cosmic-pi-deprecated/ANALOGUE-hardware/AnalogueProductionBOM.xlsx

Qty | Value | Parts | Package | Tolerance | Wattage | Voltage Rating, Type | Manufacturer | MPN | Description | Device | Side | Mounting
1 | 0 ohm | R9 | R1206 |  | 1/4W |  |  |  | RESISTOR, European symbol | R-EU_R1206 | Top | SMD
1 | 1 uH CM choke | L1 | WE-CNSW_1812 |  |  |  | Wurth | 744235601 | WE-CNSW SMD Common Mode Line Filter | WE-CNSW_1812_744235601 | Top | SMD
6 | 100n | C14, C15, C19, C20, C24, C25 | C0603 | 10% |  | 50V, X7R |  |  | CAPACITOR, European symbol | C-EUC0603 | Top | SMD
2 | 100n ECPU | C1, C16 | C0805 | 20% |  | 16V |  |  | CAPACITOR, European symbol | C-EUC0805 | Top | SMD
1 | 100u | C6 | C/6032-28R | 10% |  | 10V, Tantalum |  |  | POLARIZED CAPACITOR, European symbol | CPOL-EUC/6032-28R | Top | SMD
3 | 10K | R25, R32, R33 | R0805 | 0.1% | 125mW |  |  |  | RESISTOR, European symbol | R-EU_R0805 | Top | SMD
1 | 10n | C8 | C0603 | 10% |  | 50V, X7R |  |  | CAPACITOR, European symbol | C-EUC0603 | Top | SMD
2 | 1K | R17, R26 | R0603 | 1% | 1/10W |  |  |  | RESISTOR, European symbol | R-EU_R0603 | Top | SMD
4 | 1k | R1, R2, R15, R16 | R1206 | 1% | 1/4W |  |  |  | RESISTOR, European symbol | R-EU_R1206 | Top | SMD
1 | 1u | C7 | C0603 | 10% |  | 25V, X7R |  |  | CAPACITOR, European symbol | C-EUC0603 | Top | SMD
4 | 1u | C2, C3, C21, C22 | C1206 | 10% |  | 100V, X7R |  |  | CAPACITOR, European symbol | C-EUC1206 | Top | SMD
1 | 2.2u | C11 | C0603 | 10% |  | 10V, X7R |  |  | CAPACITOR, European symbol | C-EUC0603 | Top | SMD
2 | 20 | R7, R8 | R0603 | 1% | 1/10W |  |  |  | RESISTOR, European symbol | R-EU_R0603 | Top | SMD
1 | 22-23-2021 | X3 | 22-23-2021 |  |  |  | MOLEX | 22-23-2021 | .100 (2.54mm) Center Header - 2 Pin" | 22-23-2021 | Top | TH
2 | 22-23-2041 | X1, X2 | 22-23-2041 |  |  |  | MOLEX | 22-23-2041 | .100 (2.54mm) Center Header - 4 Pin" | 22-23-2041 | Top | TH
2 | 30K | R18, R27 | R0603 | 1% | 1/10W |  |  |  | RESISTOR, European symbol | R-EU_R0603 | Top | SMD
2 | 30p NP0 | C4, C17 | C0603 | 5% |  | 50V, NPO |  |  | CAPACITOR, European symbol | C-EUC0603 | Top | SMD
1 | 330 | R22 | R0603 | 1% | 1/10W |  |  |  | RESISTOR, European symbol | R-EU_R0603 | Top | SMD
2 | 5100 | R24, R28 | R0603 | 1% | 1/8W |  |  |  | RESISTOR, European symbol | R-EU_R0603 | Top | SMD
2 | AD8039 | IC1, IC2 | SO8 |  |  |  | Analogue Devices | AD8039ARZ | Low Power, 350 MHz Voltage Feedback Amplifiers, 3V | AD8039R | Top | SMD
2 | BAS70-04 | D3, D4 | SOT23 |  |  |  | Vishay | BAS70-04-E3-08 | Silicon Schottky Diodes | BAS70-04 | Top | SMD
1 | LP2985IM5-3.1 | IC3 | SOT95P284X120-5N |  |  |  | Texas Instruments | LP2985IM5-3.3/NOPB | Low-Dropout Regulator | LP2985IM5-3.1 | Top | SMD
2 | U.FL-R-SMT-1(10) | J1, J2 | HRS_U.FL-R-SMT-1(10) |  |  |  | Hirose | U.FL-R-SMT-1(10) | U.FL, Ultra Miniature Coaxial Connector Receptacle, Male Pin 50 Ohm Surface Mount Solder | U.FL-R-SMT-1(10) | Top | SMD
1 | top-mounted | LED1 | LED_SML0603 |  |  |  | LTST-S270TBKT-5A |  | 0603 Blue LED | LED_ESML0603 | Top | SMD
