cosmic-pi-deprecated/ANALOGUE-hardware/Cosmic Pi Analogue V2.5 OHL.pdf

# Signal

# +4V Regulated Power Supply

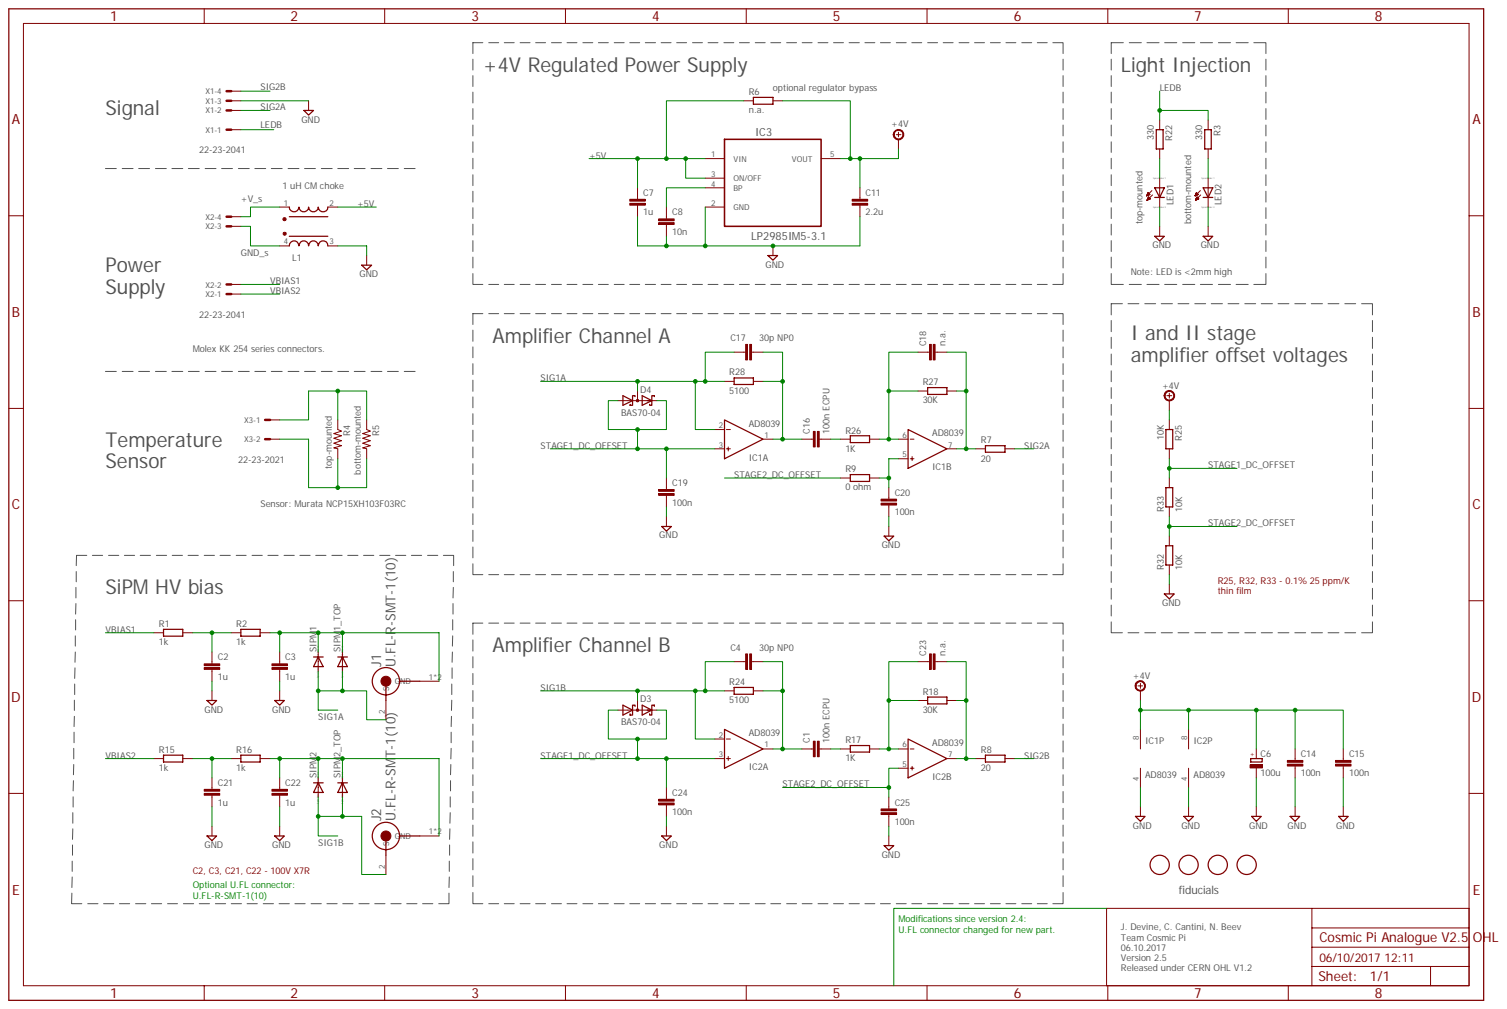
[picture p1: page 1]

Note: LED is <2mm high

Molex KK 254 series connectors.

SpiceOrder 1 SpiceOrder 2

Modifications since version 2.4:
U.FL connector changed for new part.

J. Devine, C. Cantini, N. Beev
Team Cosmic Pi
Version 2.5
Released under CERN OHL V1.2
