cosmic-pi-deprecated/ANALOGUE-hardware/Cosmic Pi Analogue V2.5 OHL no logo.brd

## EAGLE design Cosmic Pi Analogue V2.5 OHL no logo.brd (2017-10-26)

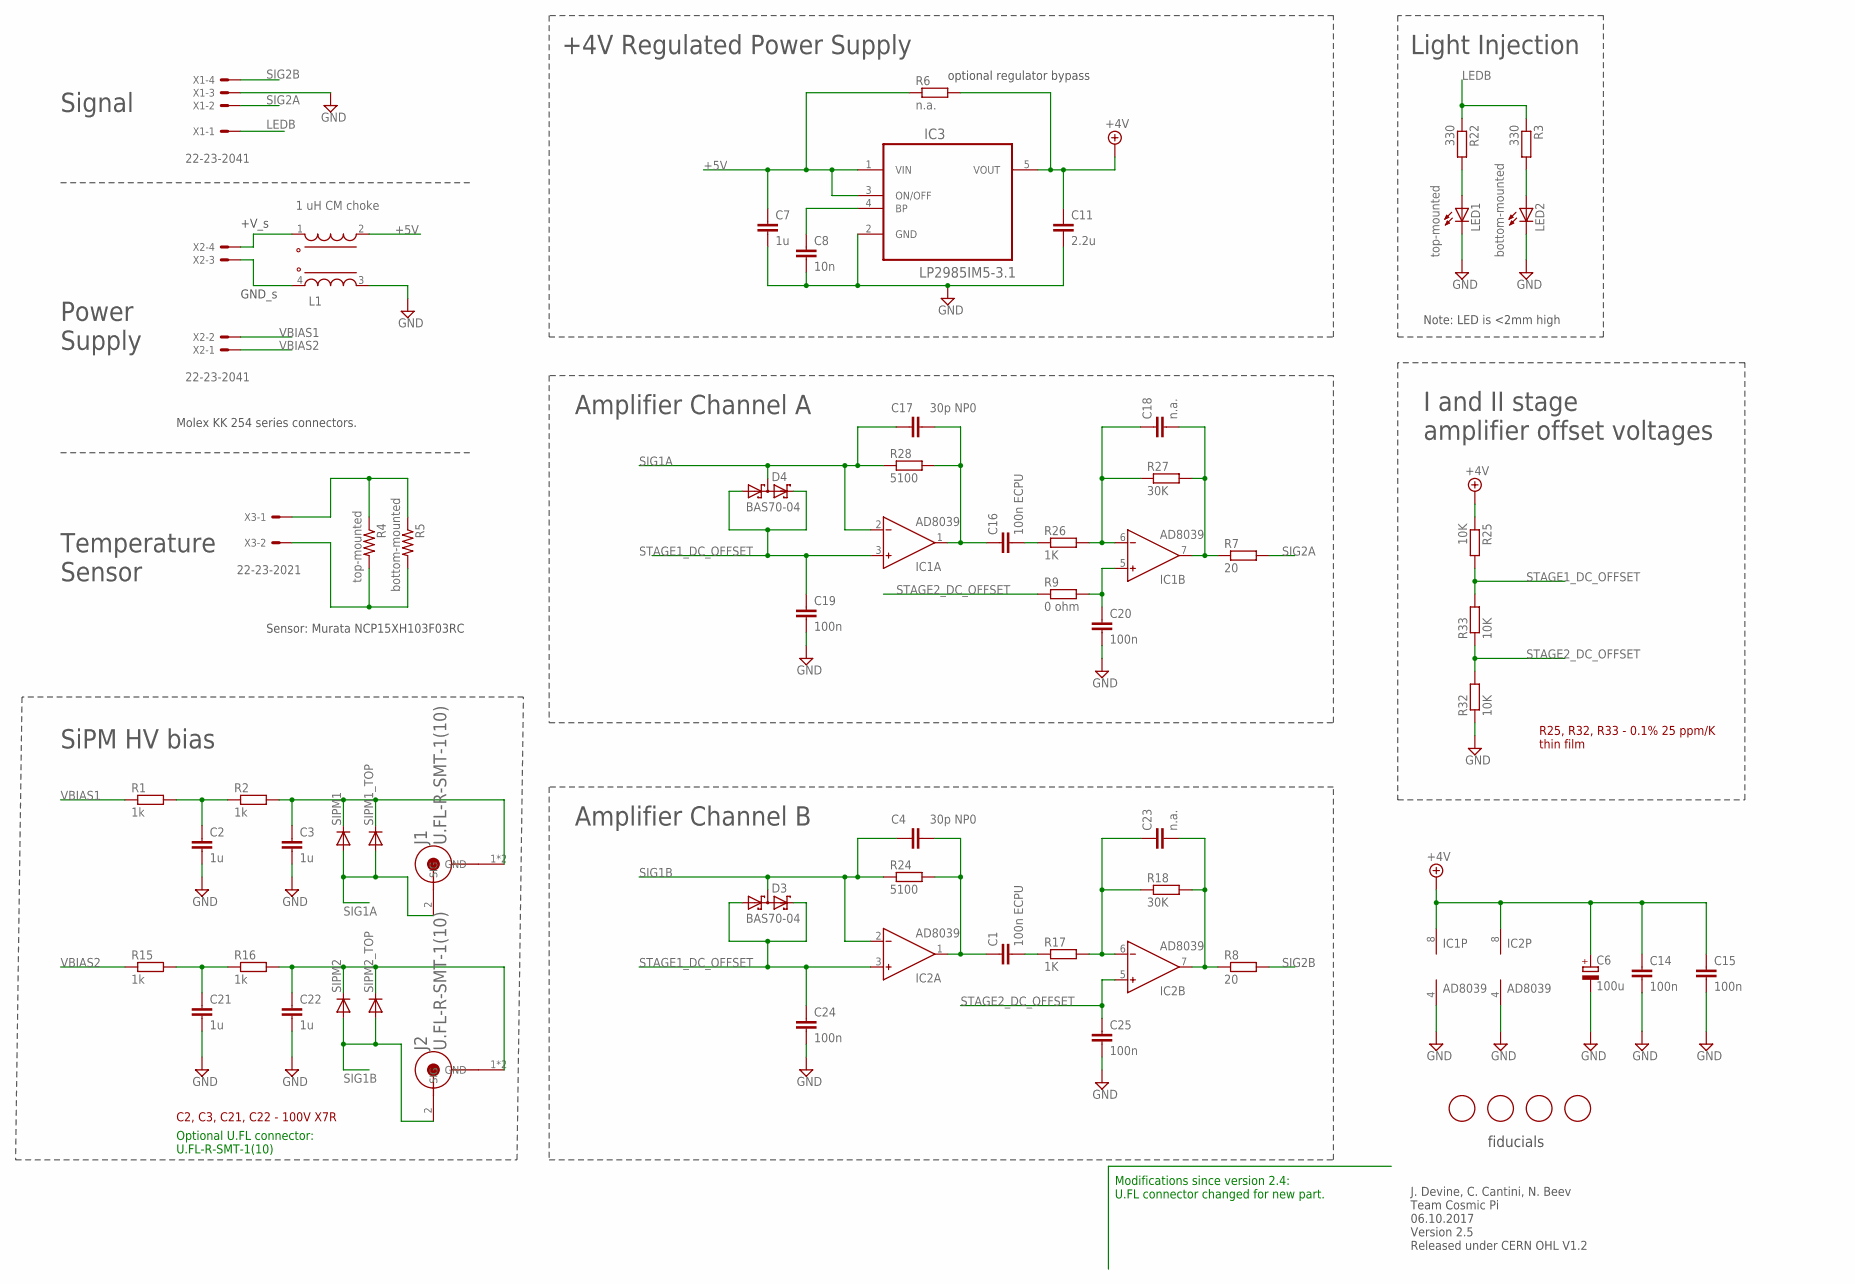
[picture p2: schematic Cosmic Pi Analogue V2.5 OHL no logo.sch]

Parts:
C1, C16: 100n ECPU; C0805
C2, C3, C21, C22: 1u; C1206
C4, C17: 30p NP0; C0603
C6: 100u; C/6032-28R
C7: 1u; C0603
C8: 10n; C0603
C11: 2.2u; C0603
C14, C15, C19, C20, C24, C25: 100n; C0603
C18, C23: n.a.; C0603
D3, D4: BAS70-04; SOT23
IC1, IC2: AD8039; SO8
IC3: LP2985IM5-3.1; SOT95P284X120-5N
J1, J2: U.FL-R-SMT-1(10); HRS_U.FL-R-SMT-1(10)
L1: 1 uH CM choke; WE-CNSW_1812
LED1: top-mounted; LED_SML0603
LED2: bottom-mounted; LED_SML0603
R1, R2, R15, R16: 1k; R1206
R3, R22: 330; R0603
R4: top-mounted; R0402
R5: bottom-mounted; R0402
R6: n.a.; R0603
R7, R8: 20; R0603
R9: 0 ohm; R1206
R17, R26: 1K; R0603
R18, R27: 30K; R0603
R24, R28: 5100; R0603
R25, R32, R33: 10K; R0805
SIPM1, SIPM1_TOP, SIPM2, SIPM2_TOP: DIODE-ADVANSID; ASD-NUV3S-P
U$2, U$3, U$4, U$5: FIDUCIAL; FIDUCIAL_1MM
X1, X2: 22-23-2041
X3: 22-23-2021

Connections:
+4V: C6.+, C11.1, C14.1, C15.1, IC1.8 (V+), IC2.8 (V+), IC3.5 (VOUT), R6.2, R25.1
+5V: C7.1, IC3.1 (VIN), IC3.3 (ON/OFF), L1.2 (3), R6.1
GND: C2.2, C3.2, C6.-, C7.2, C8.2, C11.2, C14.2, C15.2, C19.2, C20.2, C21.2, C22.2, C24.2, C25.2, IC1.4 (V-), IC2.4 (V-), IC3.2 (GND), L1.3 (2), LED1.C, LED2.C, R32.1, X1.3
LEDB: R3.1, R22.1, X1.1
unnamed: L1.1 (4), X2.4
unnamed: L1.4 (1), X2.3
unnamed: LED2.A, R3.2
unnamed: C8.1, IC3.4 (BP)
unnamed: C21.1, R15.2, R16.1
unnamed: C18.2, IC1.7 (OUT), R7.1, R27.2
unnamed: C22.1, J2.1 (GND), J2.3 (GND), R16.2, SIPM2.P$1 (C), SIPM2_TOP.P$1 (C)
unnamed: R4.1, R5.1, X3.1
unnamed: C23.2, IC2.7 (OUT), R8.1, R18.2
unnamed: C2.1, R1.2, R2.1
unnamed: R4.2, R5.2, X3.2
unnamed: C20.1, IC1.5 (IN+), R9.2
unnamed: C3.1, J1.1 (GND), J1.3 (GND), R2.2, SIPM1.P$1 (C), SIPM1_TOP.P$1 (C)
unnamed: LED1.A, R22.2
unnamed: C1.1, C4.2, IC2.1 (OUT), R24.2
unnamed: C1.2, R17.1
unnamed: C23.1, IC2.6 (IN-), R17.2, R18.1
unnamed: C16.1, C17.2, IC1.1 (OUT), R28.2
unnamed: C16.2, R26.1
unnamed: C18.1, IC1.6 (IN-), R26.2, R27.1
SIG1A: C17.1, D4.3 (C1A2), IC1.2 (IN-), J1.2 (SIG), R28.1, SIPM1.P$2 (A), SIPM1_TOP.P$2 (A)
SIG1B: C4.1, D3.3 (C1A2), IC2.2 (IN-), J2.2 (SIG), R24.1, SIPM2.P$2 (A), SIPM2_TOP.P$2 (A)
SIG2A: R7.2, X1.2
SIG2B: R8.2, X1.4
STAGE1_DC_OFFSET: C19.1, C24.1, D3.1 (A1), D3.2 (C2), D4.1 (A1), D4.2 (C2), IC1.3 (IN+), IC2.3 (IN+), R25.2, R33.2
STAGE2_DC_OFFSET: C25.1, IC2.5 (IN+), R9.1, R32.2, R33.1
VBIAS1: R1.1, X2.2
VBIAS2: R15.1, X2.1

Notes on the sheet:
J. Devine, C. Cantini, N. Beev Team Cosmic Pi 06.10.2017 Version 2.5 Released under CERN OHL V1.2
Signal
Power Supply
Molex KK 254 series connectors.
Note: LED is <2mm high
+4V Regulated Power Supply
Amplifier Channel A
Amplifier Channel B
SiPM HV bias
Temperature Sensor
optional regulator bypass
+V_s
GND_s
Light Injection
I and II stage amplifier offset voltages
fiducials
Sensor: Murata NCP15XH103F03RC
R25, R32, R33 - 0.1% 25 ppm/K thin film
C2, C3, C21, C22 - 100V X7R
Optional U.FL connector: U.FL-R-SMT-1(10)
Modifications since version 2.4: U.FL connector changed for new part.

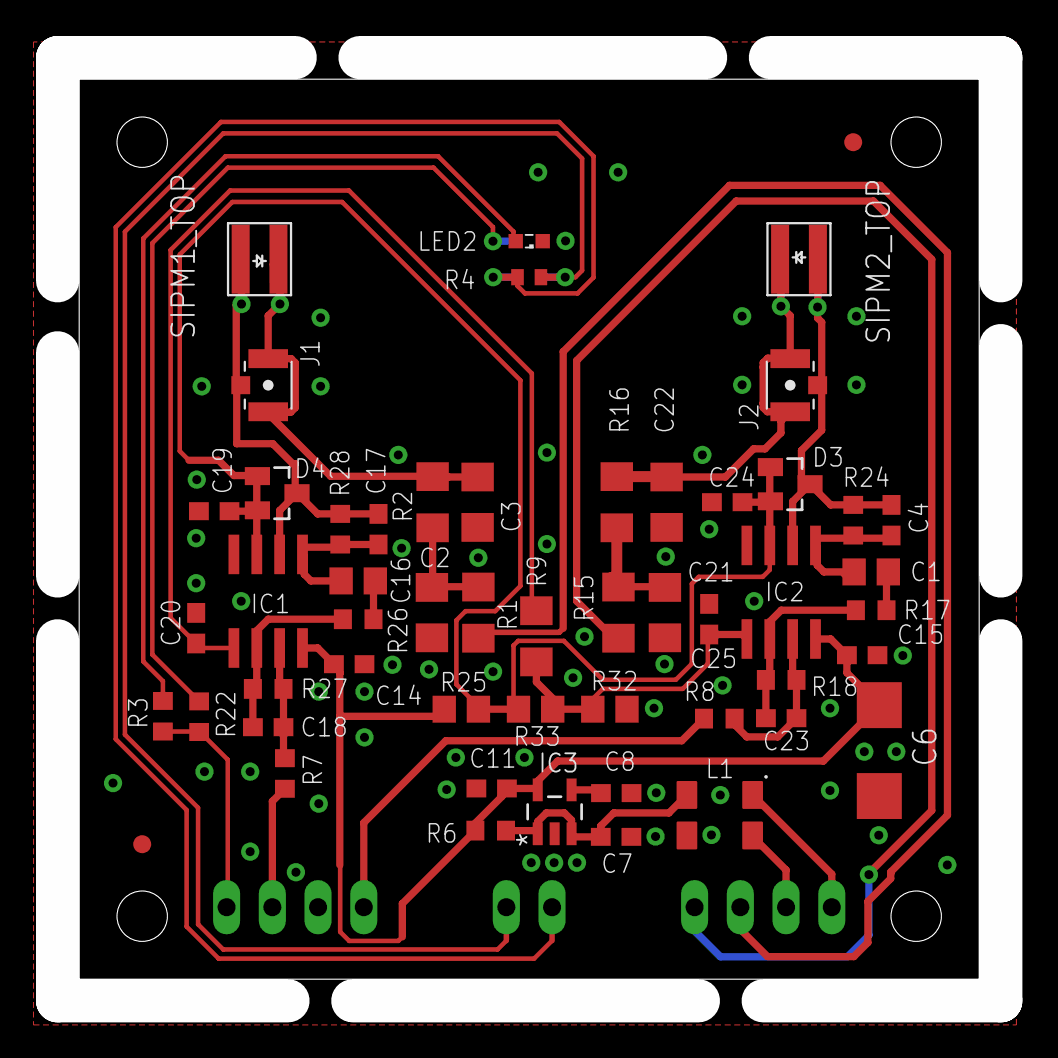
[picture p3: board Cosmic Pi Analogue V2.5 OHL no logo.brd from above]

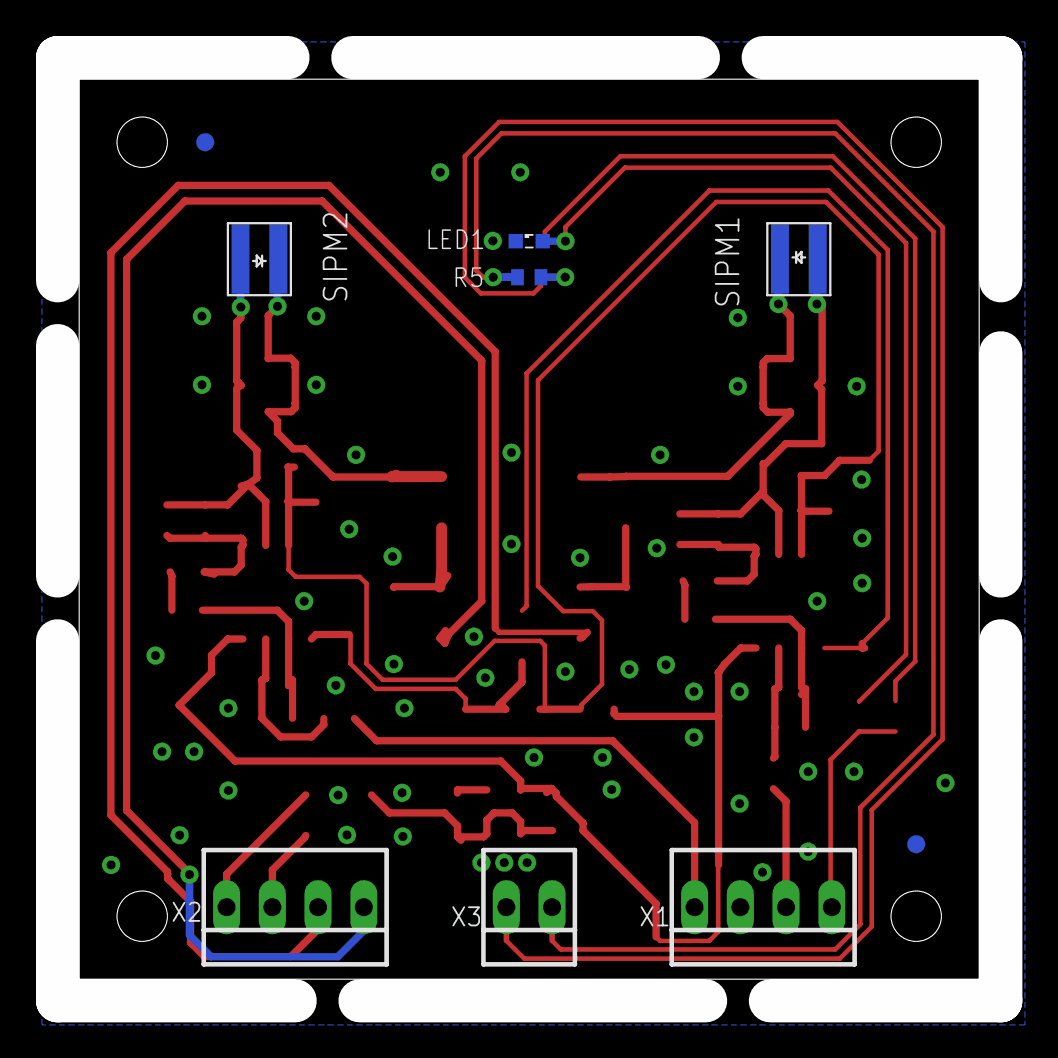
[picture p4: board Cosmic Pi Analogue V2.5 OHL no logo.brd from below]

Board: 2 copper layers, 52.4 x 52.4 mm, 62 parts (9 on the bottom side), 32 nets.
