cosmic-pi-deprecated/ANALOGUE-hardware/(commit log)

2017-09-11 First update
    [Cosmic Pi Analogue V2.4 OHL BOM.csv, Cosmic Pi Analogue V2.4 OHL_logo.brd, Cosmic Pi Analogue V2.4 OHL_logo.sch]
2017-10-26 Version 2.5 production update
    [AnalogueProductionBOM.xlsx, Cosmic Pi Analogue V2.5 OHL no logo.brd, Cosmic Pi Analogue V2.5 OHL no logo.sch]
2018-01-28 Wrong part number identified and corrected IC1, IC2, IC3 and IC4
    The AD8039 was incorrectly tagged as an AD8033 in the extended description fields and in the BOM spreadsheet. This has now been corrected. Based on production testing, analogue units with the AD8033 IC's fitted are still functional with the Cosmic Pi Main Board V2.5 production units. I'm not entirely sure why/how they still work, but it's been tested (stack/unstack - https://www.youtube.com/watch?v=crR5aZPUKPI), and they do.
    [AnalogueProductionBOM.xlsx]
